Isma1306/air-quality-matter/images/homeAssistant.webp

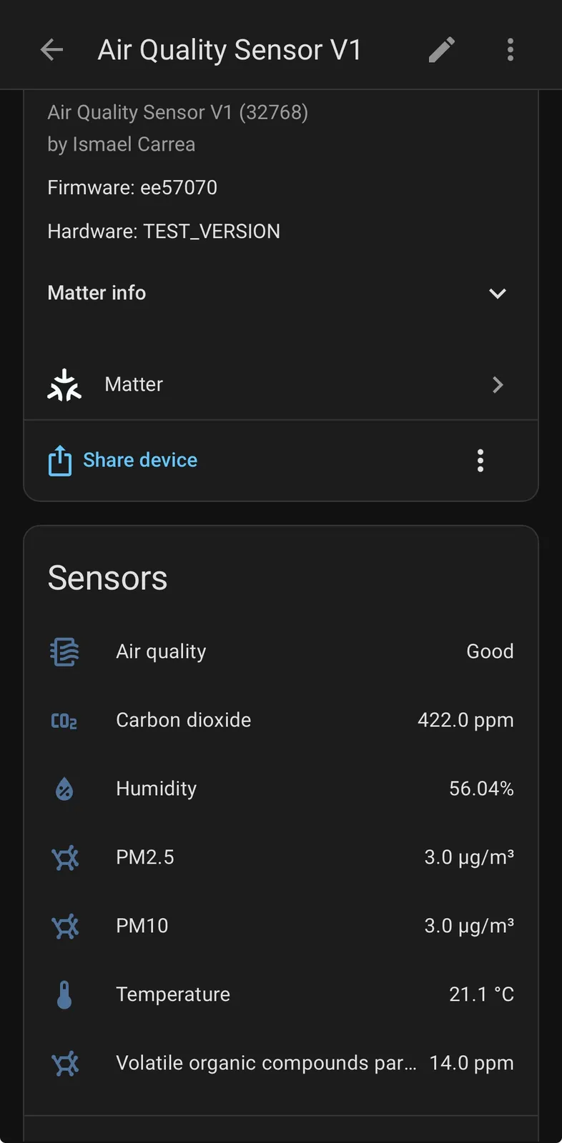
images/homeAssistant.webp
