Isma1306/air-quality-matter/images/homekit.webp

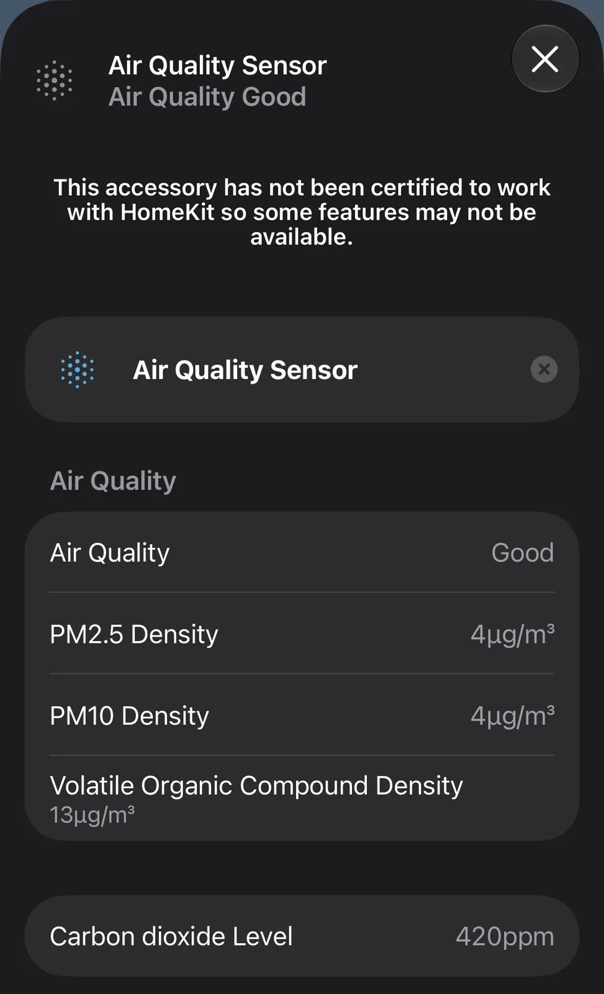
images/homekit.webp
