Isma1306/air-quality-matter/images/wired.webp

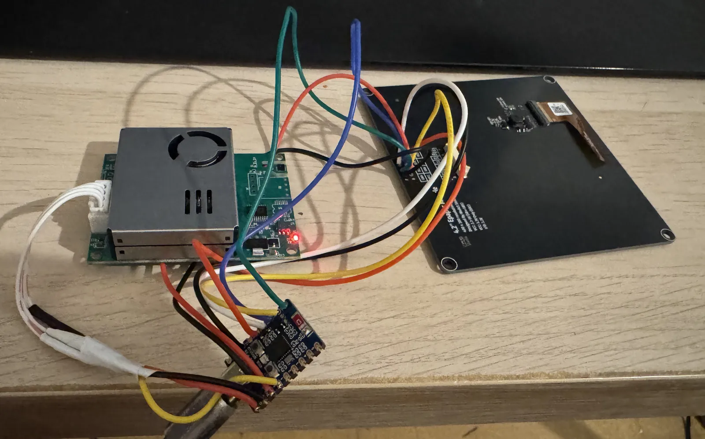
images/wired.webp
