Isma1306/air-quality-matter/airquality_v5.3mf

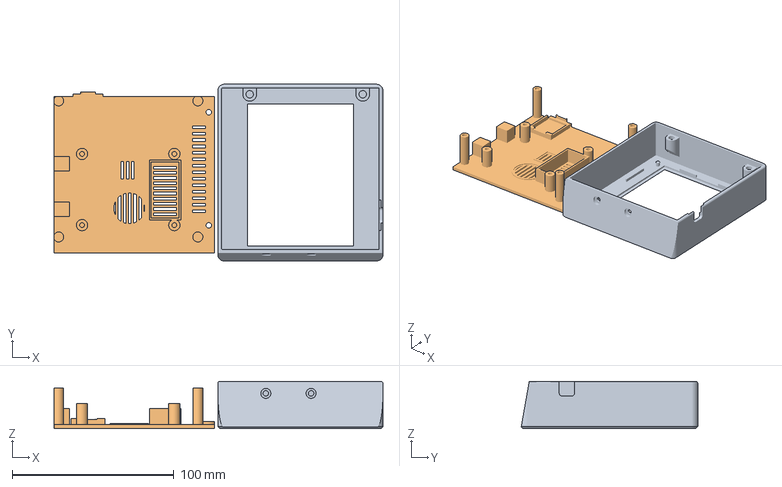
[picture p5: CAD file, 2026-11-05]
airquality_v5.3mf
203.6 x 109.3 x 29.2 mm
airquality_v5_body.stl
airquality_v5_lid.stl
