Isma1306/air-quality-matter/(commit log)

2026-11-05 more improvements and added the 3d case file
    [airquality_v5.3mf]
2026-11-06 fixed readme, added images and rename it
    [sensorMonitor_v1.ino]
